Sgw32/BulkyMIDI-32/faceplates/BulkyMIDI-32 Dexed SH1106 FP4/jlcpcb/production_files/BOM-BulkyMIDI-32 Dexed FP4.csv

Comment | Designator | Footprint | LCSC | Quantity
Mounting_Pin | M1 | M3_pin |  | 1
Mounting_Pin | M2 | M3_pin |  | 1
Mounting_Pin | M3 | M3_pin |  | 1
Mounting_Pin | M4 | M3_pin |  | 1
