Sgw32/BulkyMIDI-32/BulkyMIDI-32 Module/BulkyMIDI-32 Module.kicad_pcb

## KiCad design BulkyMIDI-32 Module/BulkyMIDI-32 Module.kicad_pcb (2026-03-25)

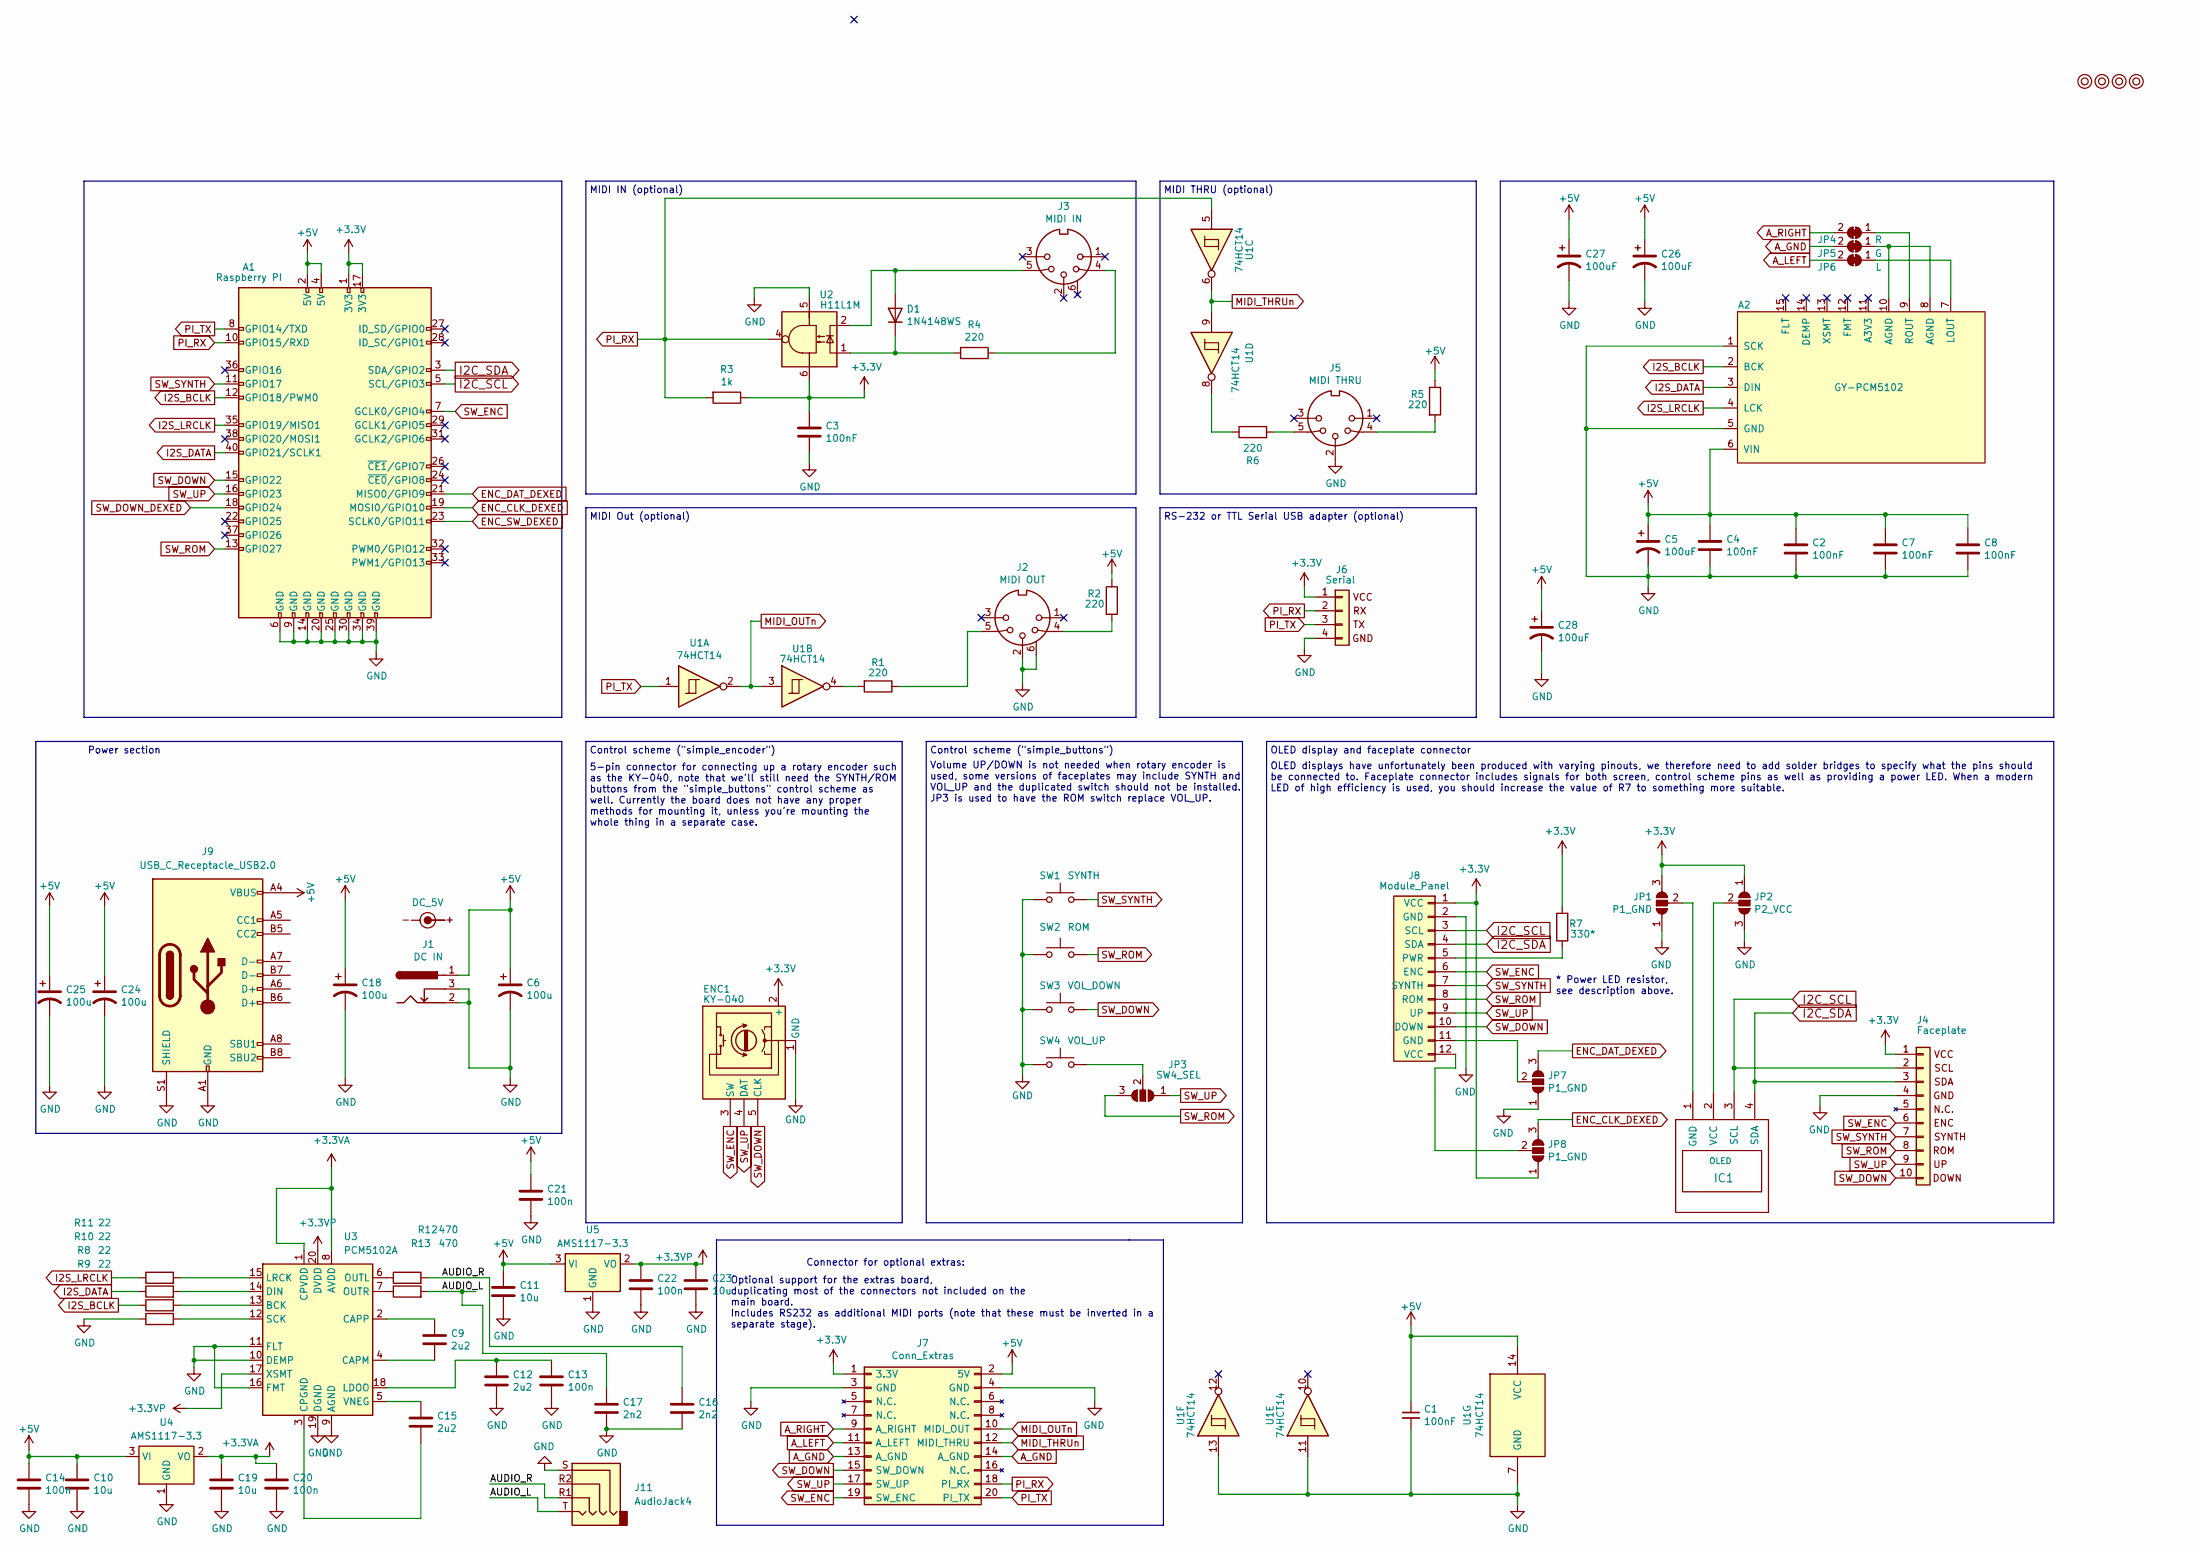
[picture p1: schematic BulkyMIDI-32 Module.kicad_sch]

Parts:
A1: Raspberry PI; Raspberry_Pi_3B_Socketed_THT_FaceDown_MountingHoles
A2: GY-PCM5102
C1, C2, C3, C4, C7, C8: 100nF; C_0402_1005Metric
C5, C26, C27, C28: 100uF; CP_EIA-3528-21_Kemet-B
C6, C18, C24, C25: 100u; CP_EIA-3528-21_Kemet-B
C9, C12, C15: 2u2; C_0402_1005Metric
C10, C11, C19, C23: 10u; C_0402_1005Metric
C13, C14, C20, C21, C22: 100n; C_0402_1005Metric
C16, C17: 2n2; C_0402_1005Metric
D1: 1N4148WS; D_SOD-323
ENC1: KY-040; PinHeader_1x05_P2.54mm_Horizontal
IC1: OLED; 1.3_I2C_OLED_No_mounting
J1: DC IN; BarrelJack_CLIFF_FC681465S_SMT_Horizontal
J2: MIDI OUT; DIN5_MIDI_OUT
J3: MIDI IN; DIN5_MIDI_IN
J4: Faceplate; PinSocket_1x10_P2.54mm_Vertical
J5: MIDI THRU; PinHeader_1x05_P2.54mm_Horizontal
J6: Serial; PinHeader_1x04_P2.54mm_Horizontal
J7: Conn_Extras; PinSocket_2x10_P2.54mm_Vertical
J8: Module_Panel
J9: USB_C_Receptacle_USB2.0; USB_C_Receptacle_XKB_U262-16XN-4BVC11
J11: AudioJack4; Jack_3.5mm_PJ320D_Horizontal
JP1, JP7, JP8: P1_GND; SolderJumper-3_P1.3mm_Open_RoundedPad1.0x1.5mm
JP2: P2_VCC; SolderJumper-3_P1.3mm_Open_RoundedPad1.0x1.5mm
JP3: SW4_SEL; SolderJumper-3_P1.3mm_Open_RoundedPad1.0x1.5mm
JP4: R; SolderJumper-2_P1.3mm_Open_TrianglePad1.0x1.5mm
JP5: G; SolderJumper-2_P1.3mm_Open_TrianglePad1.0x1.5mm
JP6: L; SolderJumper-2_P1.3mm_Open_TrianglePad1.0x1.5mm
M1, M2, M3, M4: Mounting; M3
R1, R2, R4, R5, R6: 220; R_0805_2012Metric
R3: 1k; R_0805_2012Metric
R7: 330*; R_0805_2012Metric
R8, R9, R10, R11: 22; R_0402_1005Metric
R12, R13: 470; R_0402_1005Metric
SW1: SYNTH; SW_Tactile_SPST_Angled_PTS645Vx39-2LFS
SW2: ROM; SW_Tactile_SPST_Angled_PTS645Vx39-2LFS
SW3: VOL_DOWN; SW_Tactile_SPST_Angled_PTS645Vx39-2LFS
SW4: VOL_UP; SW_Tactile_SPST_Angled_PTS645Vx39-2LFS
SYM1: DC_5V; PWR_Specification
U1: 74HCT14; SO-14_3.9x8.65mm_P1.27mm
U2: H11L1M; DIP-6_W7.62mm
U3: PCM5102A; TSSOP-20_4.4x6.5mm_P0.65mm
U4, U5: AMS1117-3.3; SOT-223-3_TabPin2

Connections:
+3.3VA: C19.1, C20.1, U3.1 (CPVDD), U3.8 (AVDD), U4.2 (VO)
+3.3VP: C22.1, C23.1, U3.17 (XSMT), U3.20 (DVDD), U5.2 (VO)
+3V3: A1.1 (3V3), A1.17 (3V3), C3.1, ENC1.2 (+), J4.1 (VCC), J6.1, J7.1 (3.3V), J8.1 (VCC), JP1.3 (B), JP2.1 (A), JP8.1 (A), R3.1, R7.2, U2.6
+5V: A1.2 (5V), A1.4 (5V), A2.6 (VIN), C1.1, C2.1, C4.1, C5.1, C6.1, C7.1, C8.1, C10.1, C11.1, C14.1, C18.1, C21.1, C24.1, C25.1, C26.1, C27.1, C28.1, J1.1, J7.2 (5V), J9.A4 (VBUS), J9.A9 (VBUS), J9.B4 (VBUS), J9.B9 (VBUS), R2.1, R5.1, U1.14 (VCC), U4.3 (VI), U5.3 (VI)
/AUDIO_L: C17.1, J11.T, R13.2
/AUDIO_R: C16.1, J11.R1, R12.2
A_GND: J7.13 (A_GND), J7.14 (A_GND), JP5.2 (B)
A_LEFT: J7.11 (A_LEFT), JP6.2 (B)
A_RIGHT: J7.9 (A_RIGHT), JP4.2 (B)
ENC_CLK_DEXED: A1.19 (MOSI0/GPIO10), JP8.3 (B)
ENC_DAT_DEXED: A1.21 (MISO0/GPIO9), JP7.3 (B)
ENC_SW_DEXED: A1.23 (SCLK0/GPIO11)
GND: A1.6 (GND), A1.9 (GND), A1.14 (GND), A1.20 (GND), A1.25 (GND), A1.30 (GND), A1.34 (GND), A1.39 (GND), A2.1 (SCK), A2.5 (GND), C1.2, C2.2, C3.2, C4.2, C5.2, C6.2, C7.2, C8.2, C10.2, C11.2, C12.2, C13.2, C14.2, C16.2, C17.2, C18.2, C19.2, C20.2, C21.2, C22.2, C23.2, C24.2, C25.2, C26.2, C27.2, C28.2, ENC1.1 (GND), J1.2, J1.3, J2.2, J2.6, J4.4, J5.2, J6.4, J7.3 (GND), J7.4 (GND), J8.2 (GND), J9.A1 (GND), J9.A12 (GND), J9.B1 (GND), J9.B12 (GND), J9.S1 (SHIELD), J11.S, JP1.1 (A), JP2.3 (B), JP7.1 (A), R11.1, SW1.1, SW2.1, SW3.1, SW4.1, U1.7 (GND), U1.11, U1.13, U2.5, U3.9 (AGND), U3.10 (DEMP), U3.11 (FLT), U3.16 (FMT), U3.19 (DGND), U4.1 (GND), U5.1 (GND)
I2C_SCL: A1.5 (SCL/GPIO3), IC1.3 (SCL), J4.2, J8.3 (SCL)
I2C_SDA: A1.3 (SDA/GPIO2), IC1.4 (SDA), J4.3, J8.4 (SDA)
I2S_BCLK: A1.12 (GPIO18/PWM0), A2.2 (BCK), R10.1
I2S_DATA: A1.40 (GPIO21/SCLK1), A2.3 (DIN), R9.1
I2S_LRCLK: A1.35 (GPIO19/MISO1), A2.4 (LCK), R8.1
MIDI_OUTn: J7.10 (MIDI_OUT), U1.2, U1.3
MIDI_THRUn: J7.12 (MIDI_THRU), U1.6, U1.9
unnamed: A2.7 (LOUT), JP6.1 (A)
unnamed: A2.9 (ROUT), JP4.1 (A)
unnamed: D1.2 (A), J3.5, U2.2
unnamed: D1.1 (K), R4.2, U2.1
unnamed: IC1.1 (GND), JP1.2 (C)
unnamed: IC1.2 (VCC), JP2.2 (C)
unnamed: J2.4, R2.2
unnamed: J2.5, R1.1
unnamed: J3.4, R4.1
unnamed: J5.4, R5.2
unnamed: J5.5, R6.2
unnamed: J8.5 (PWR), R7.1
unnamed: JP3.2 (C), SW4.2
unnamed: A2.8 (AGND), A2.10 (AGND), JP5.1 (A)
unnamed: J8.11 (GND), JP7.2 (C)
unnamed: J8.12 (VCC), JP8.2 (C)
unnamed: R1.2, U1.4
unnamed: R6.1, U1.8
unnamed: R10.2, U3.13 (BCK)
unnamed: C9.2, U3.4 (CAPM)
unnamed: C9.1, U3.2 (CAPP)
unnamed: C15.2, U3.3 (CPGND)
unnamed: R9.2, U3.14 (DIN)
unnamed: C12.1, C13.1, U3.18 (LDOO)
unnamed: R8.2, U3.15 (LRCK)
unnamed: R12.1, U3.6 (OUTL)
unnamed: R13.1, U3.7 (OUTR)
unnamed: R11.2, U3.12 (SCK)
unnamed: C15.1, U3.5 (VNEG)
PI_RX: A1.10 (GPIO15/RXD), J6.2, J7.18 (PI_RX), R3.2, U1.5, U2.4
PI_TX: A1.8 (GPIO14/TXD), J6.3, J7.20 (PI_TX), U1.1
SW_DOWN: A1.15 (GPIO22), ENC1.5 (CLK), J4.10 (GND), J7.15 (SW_DOWN), J8.10 (DOWN), SW3.2
SW_DOWN_DEXED: A1.18 (GPIO24)
SW_ENC: A1.7 (GCLK0/GPIO4), ENC1.3 (SW), J4.6, J7.19 (SW_ENC), J8.6 (ENC)
SW_ROM: A1.13 (GPIO27), J4.8, J8.8 (ROM), JP3.3 (B), SW2.2
SW_SYNTH: A1.11 (GPIO17), J4.7, J8.7 (SYNTH), SW1.2
SW_UP: A1.16 (GPIO23), ENC1.4 (DAT), J4.9, J7.17 (SW_UP), J8.9 (UP), JP3.1 (A)

Notes on the sheet:
OLED display and faceplate connector
Control scheme ("simple_buttons")
MIDI Out (optional)
Control scheme ("simple_encoder")
MIDI THRU (optional)
Power section
Connector for optional extras:
MIDI IN (optional)
5-pin connector for connecting up a rotary encoder such as the KY-040, note that we'll still need the SYNTH/ROM buttons from the "simple_buttons" control scheme as well. Currently the board does not have any proper methods for mounting it, unless you're mounting the whole thing in a separate case.
Optional support for the extras board, duplicating most of the connectors not included on the main board. Includes RS232 as additional MIDI ports (note that these must be inverted in a separate stage).
Volume UP/DOWN is not needed when rotary encoder is used, some versions of faceplates may include SYNTH and VOL_UP and the duplicated switch should not be installed. JP3 is used to have the ROM switch replace VOL_UP.
RS-232 or TTL Serial USB adapter (optional)
* Power LED resistor, see description above.
OLED displays have unfortunately been produced with varying pinouts, we therefore need to add solder bridges to specify what the pins should be connected to. Faceplate connector includes signals for both screen, control scheme pins as well as providing a power LED. When a modern LED of high efficie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

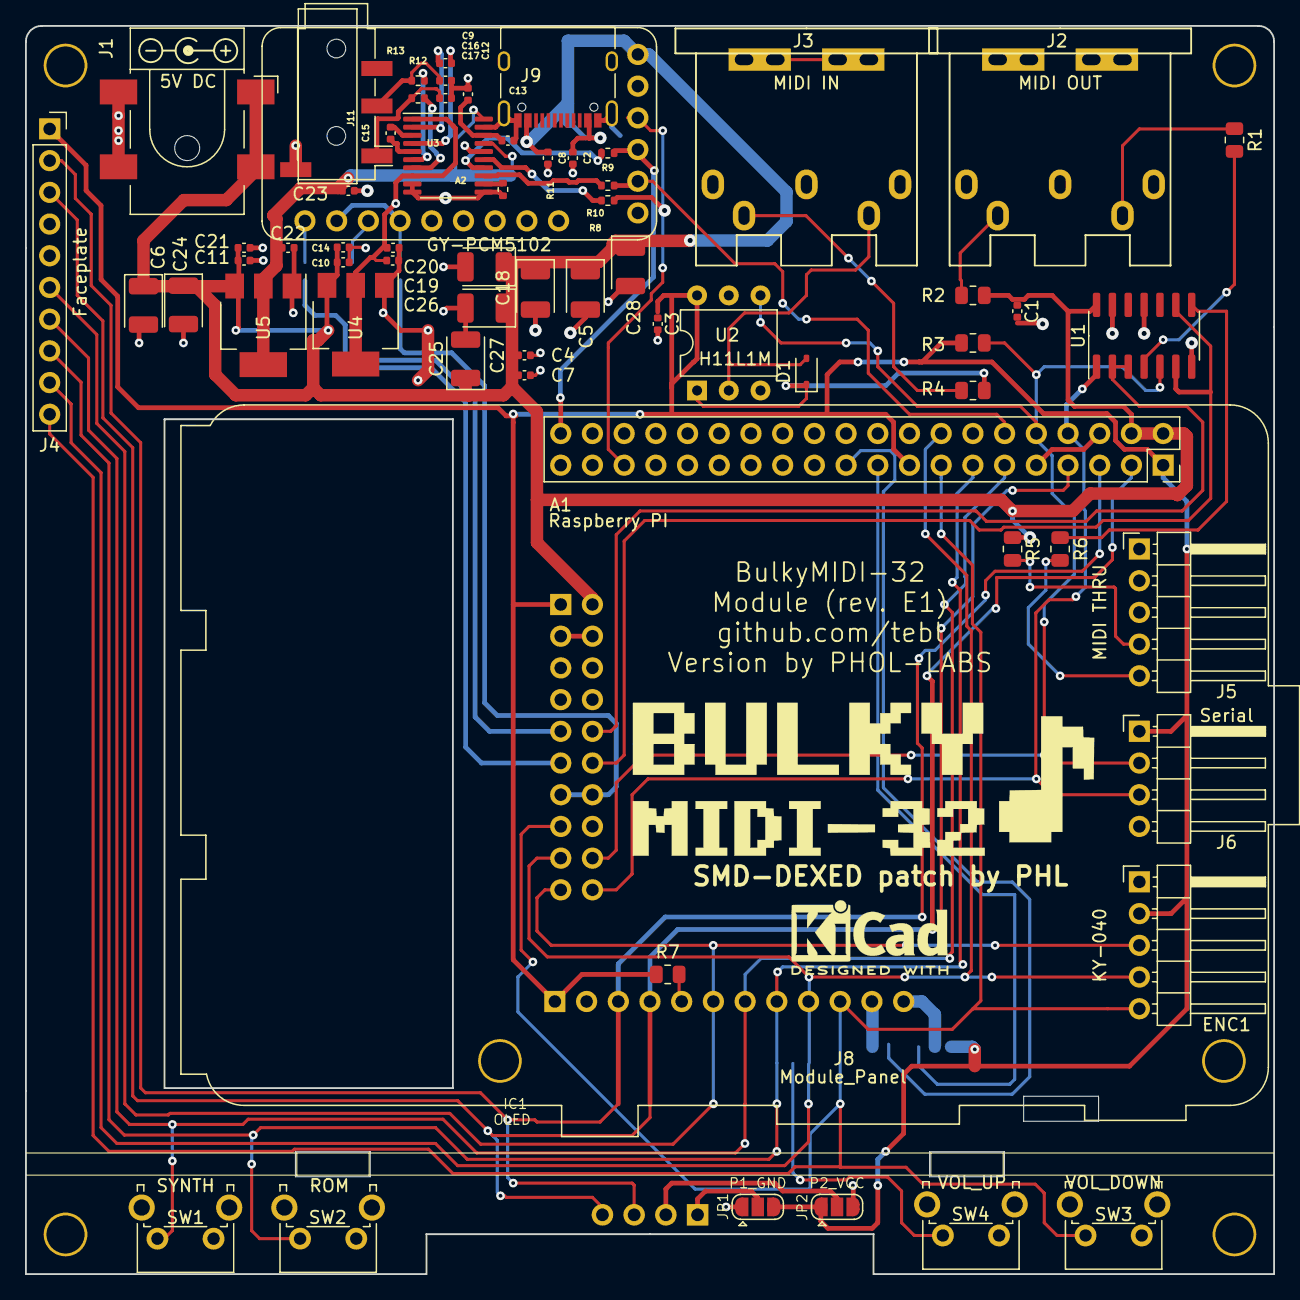
[picture p2: board BulkyMIDI-32 Module.kicad_pcb from above]

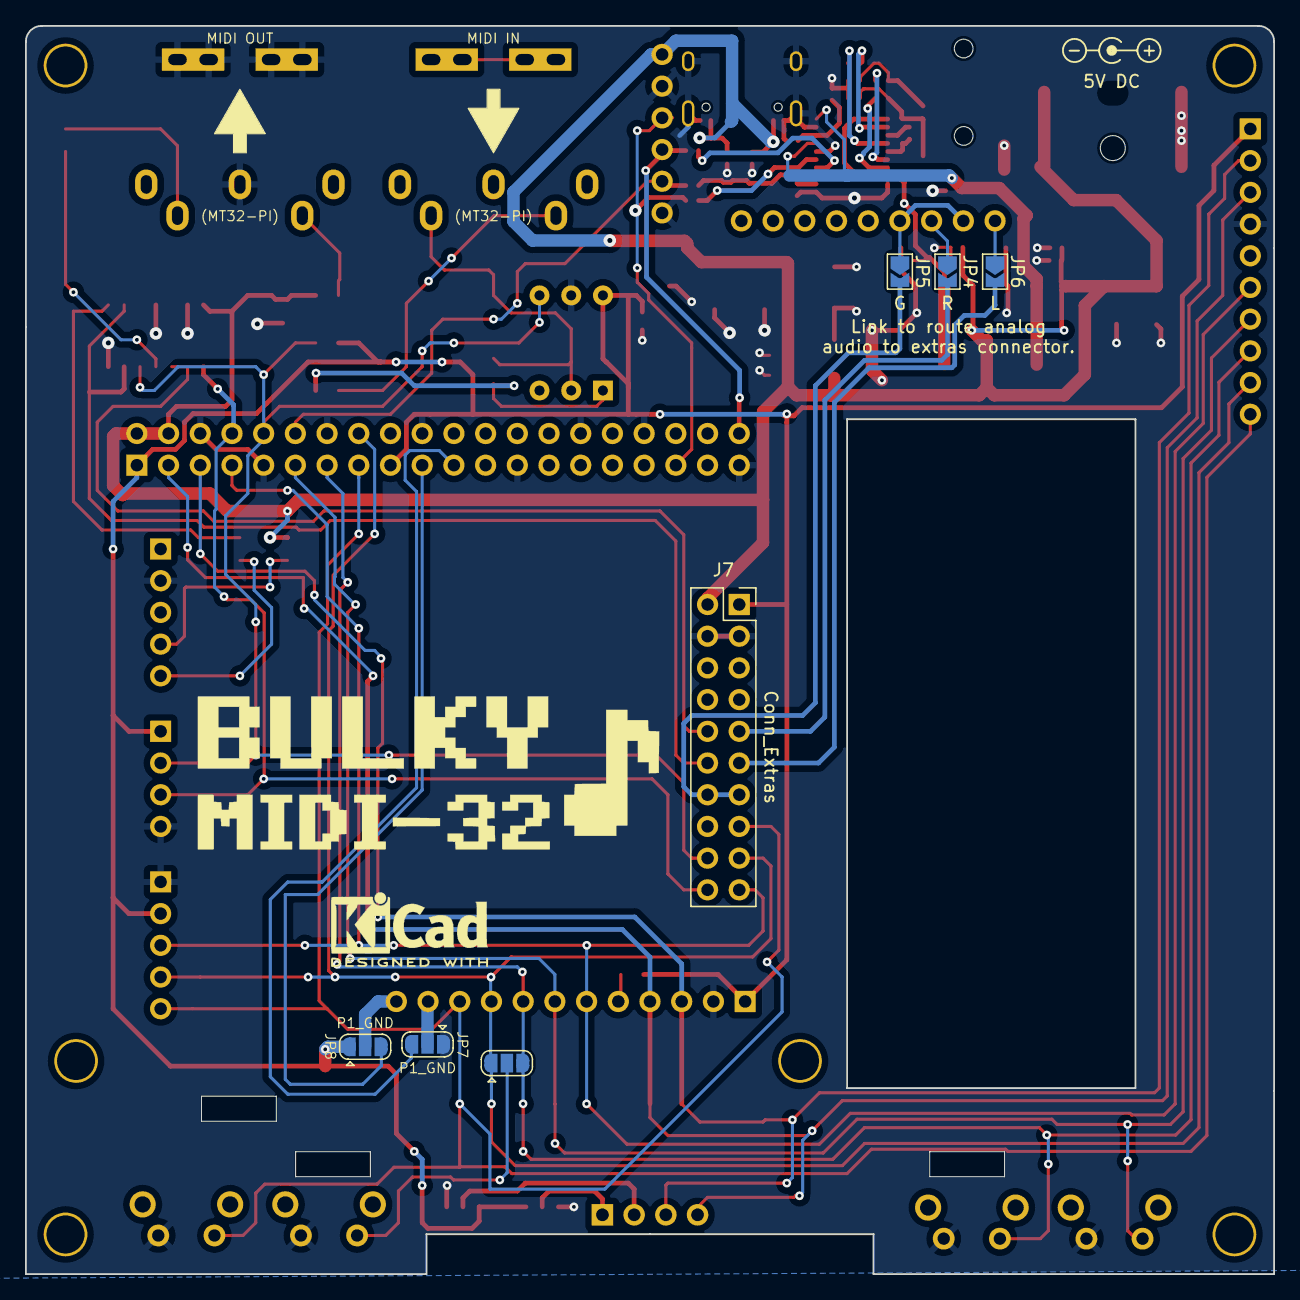
[picture p3: board BulkyMIDI-32 Module.kicad_pcb from below]

Board: 2 copper layers, 100.0 x 100.0 mm, 78 parts (7 on the bottom side), 55 nets.
