Sgw32/BulkyMIDI-32/(commit log)

2025-11-13 Type C patched
    [BOM-BulkyMIDI-32 Module.csv, BulkyMIDI-32 Module.kicad_pcb, BulkyMIDI-32 Module.kicad_sch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]
2026-03-25 Add jlc files + SH1106 Dexed
    [BOM-BulkyMIDI-32 Dexed FP4.csv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]
2026-03-25 Compact and integrated DAC with both MT32Pi and Dexed support
    [BOM-BulkyMIDI-32 Module.csv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]
